serg4life/Qeni_docs/images/prototype.jpg

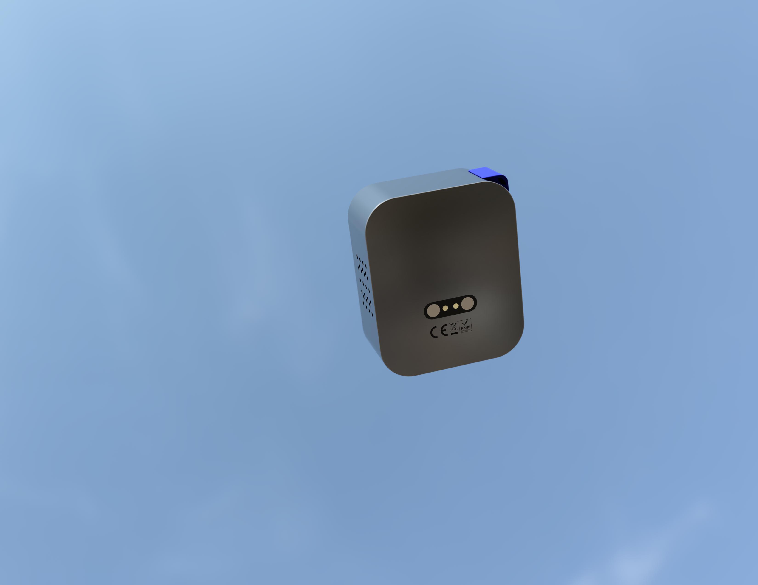
images/prototype.jpg
