serg4life/Qeni_docs/sources/Kicad/Qeniv2.step

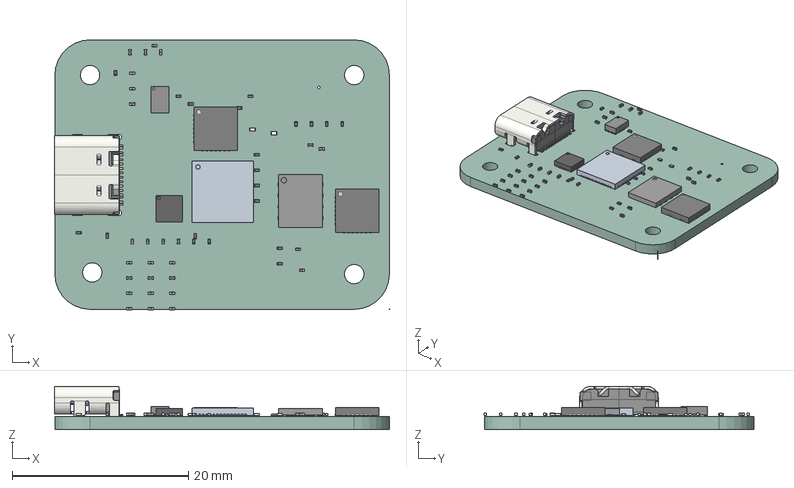
[picture p17: CAD file, 2026-11-05]
sources/Kicad/Qeniv2.step
38.0 x 30.7 x 4.91 mm
R_0201_0603Metric x 19
C_0201_0603Metric x 24
LED_0201_0603Metric x 2
QFN-28-1EP_5x5mm_P0.5mm_EP3.35x3.35mm x 2
L_0201_0603Metric x 4
Espiguchi 1.13.1
TPS62147RGXT
QFN-16 (3x3) Part1
QFN-16 (3x3) Part2 x 16
USB_C_Receptacle_GCT_USB4105-xx-A_16P_TopMnt_Horizontal
ThermalPin
PinsArrayLR
Espiguchi_PCB_1
Espiguchi_PCB_2
