serg4life/Qeni_docs/sources/Kicad/Qeniv2.kicad_pcb

## KiCad design sources/Kicad/Qeniv2.kicad_pcb (2026-11-05)

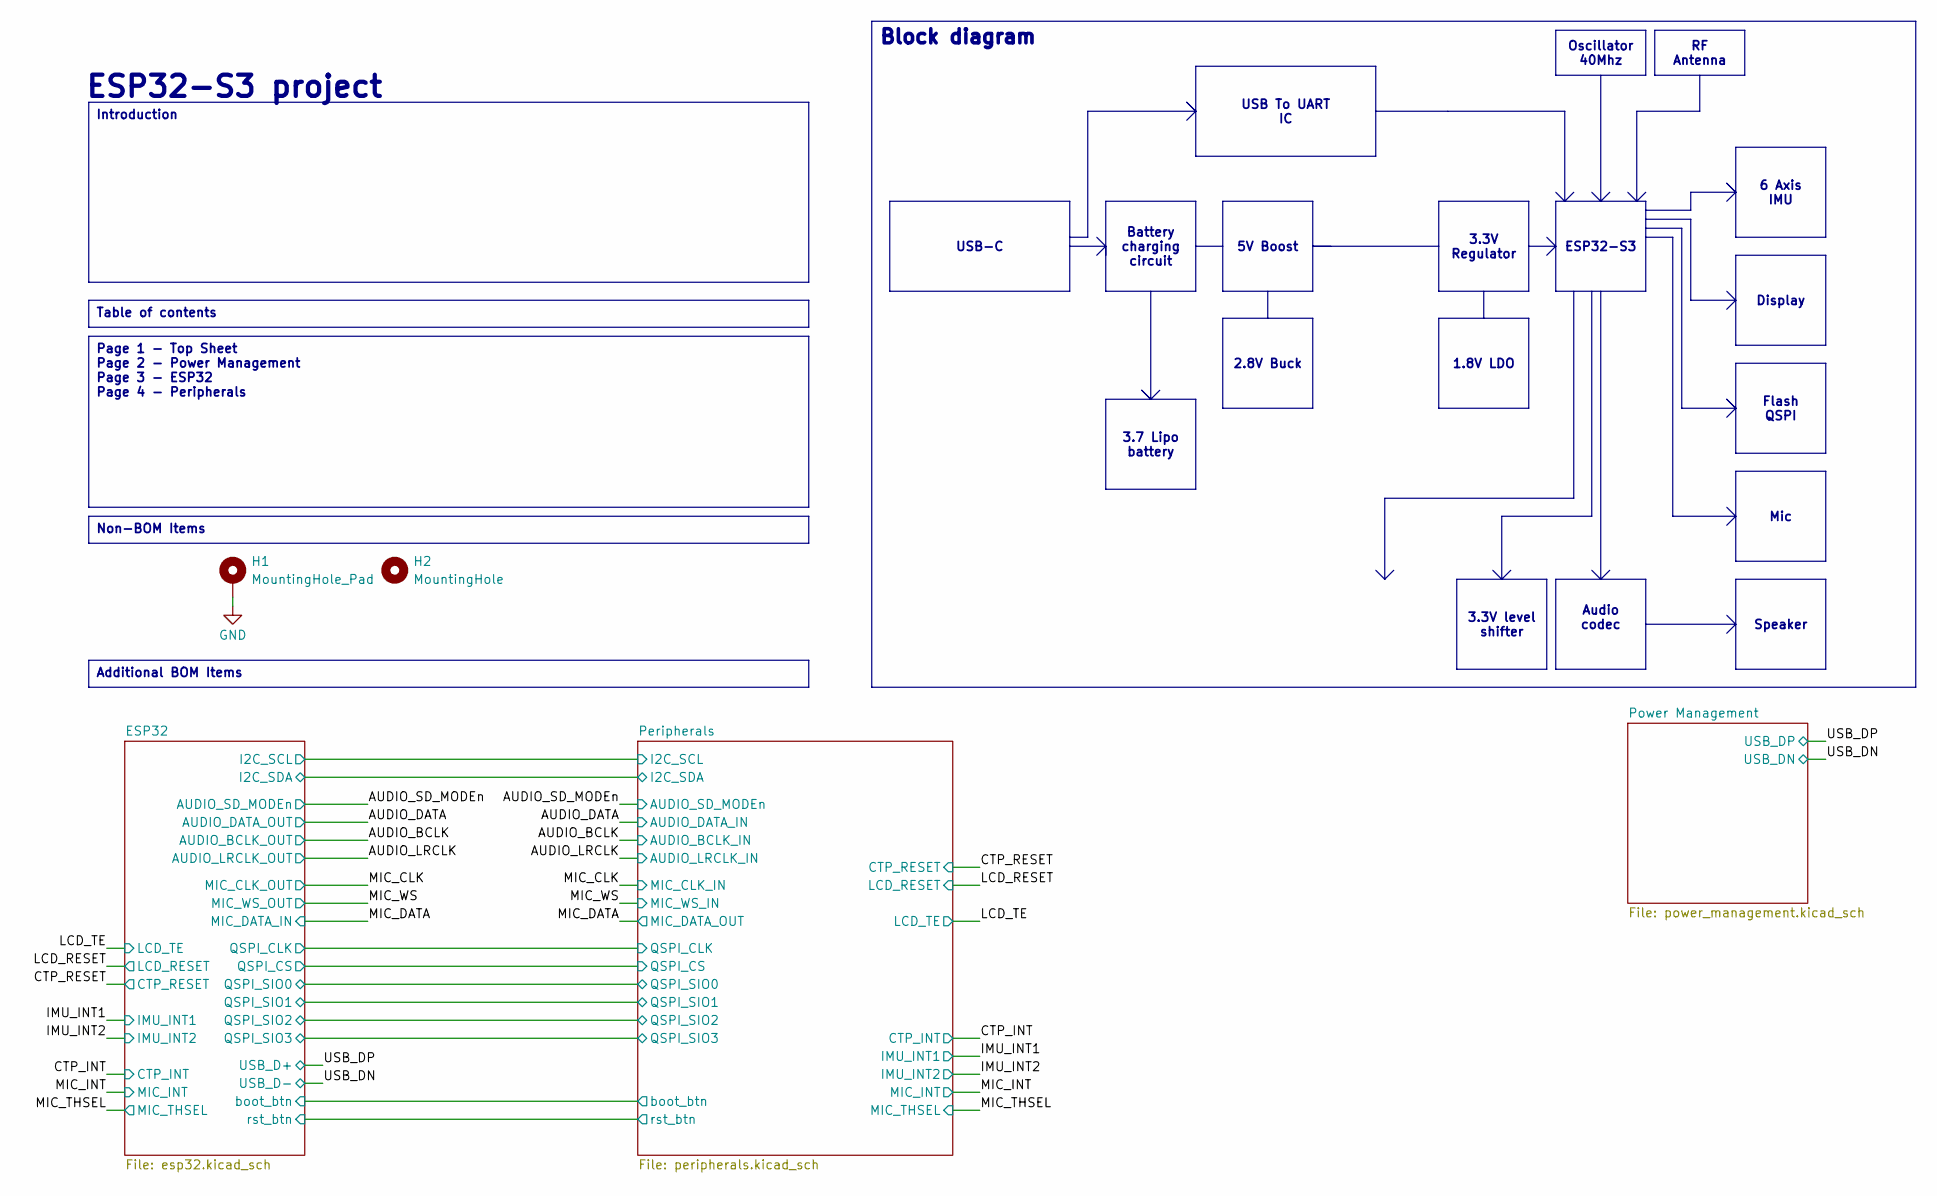
[picture p18: schematic Qeniv2.kicad_sch, Espiguchi-S3]

Parts:
H1: MountingHole_Pad; MountingHole_2.2mm_M2_ISO14580_Pad
H2: MountingHole; MountingHole_2.2mm_M2_ISO7380

Connections:
GND: H1.1; also elsewhere on the board

Notes on the sheet:
ESP32-S3 project
3.3V level shifter
RF Antenna
2.8V Buck
Additional BOM Items
Display
USB-C
6 Axis IMU
Battery charging circuit
Block diagram
Page 1 - Top Sheet Page 2 - Power Management Page 3 - ESP32 Page 4 - Peripherals
Table of contents
Introduction
Mic
1.8V LDO
ESP32-S3
Oscillator 40Mhz
5V Boost
3.3V Regulator
USB To UART IC
Audio codec
3.7 Lipo battery
Non-BOM Items
Flash QSPI
Speaker

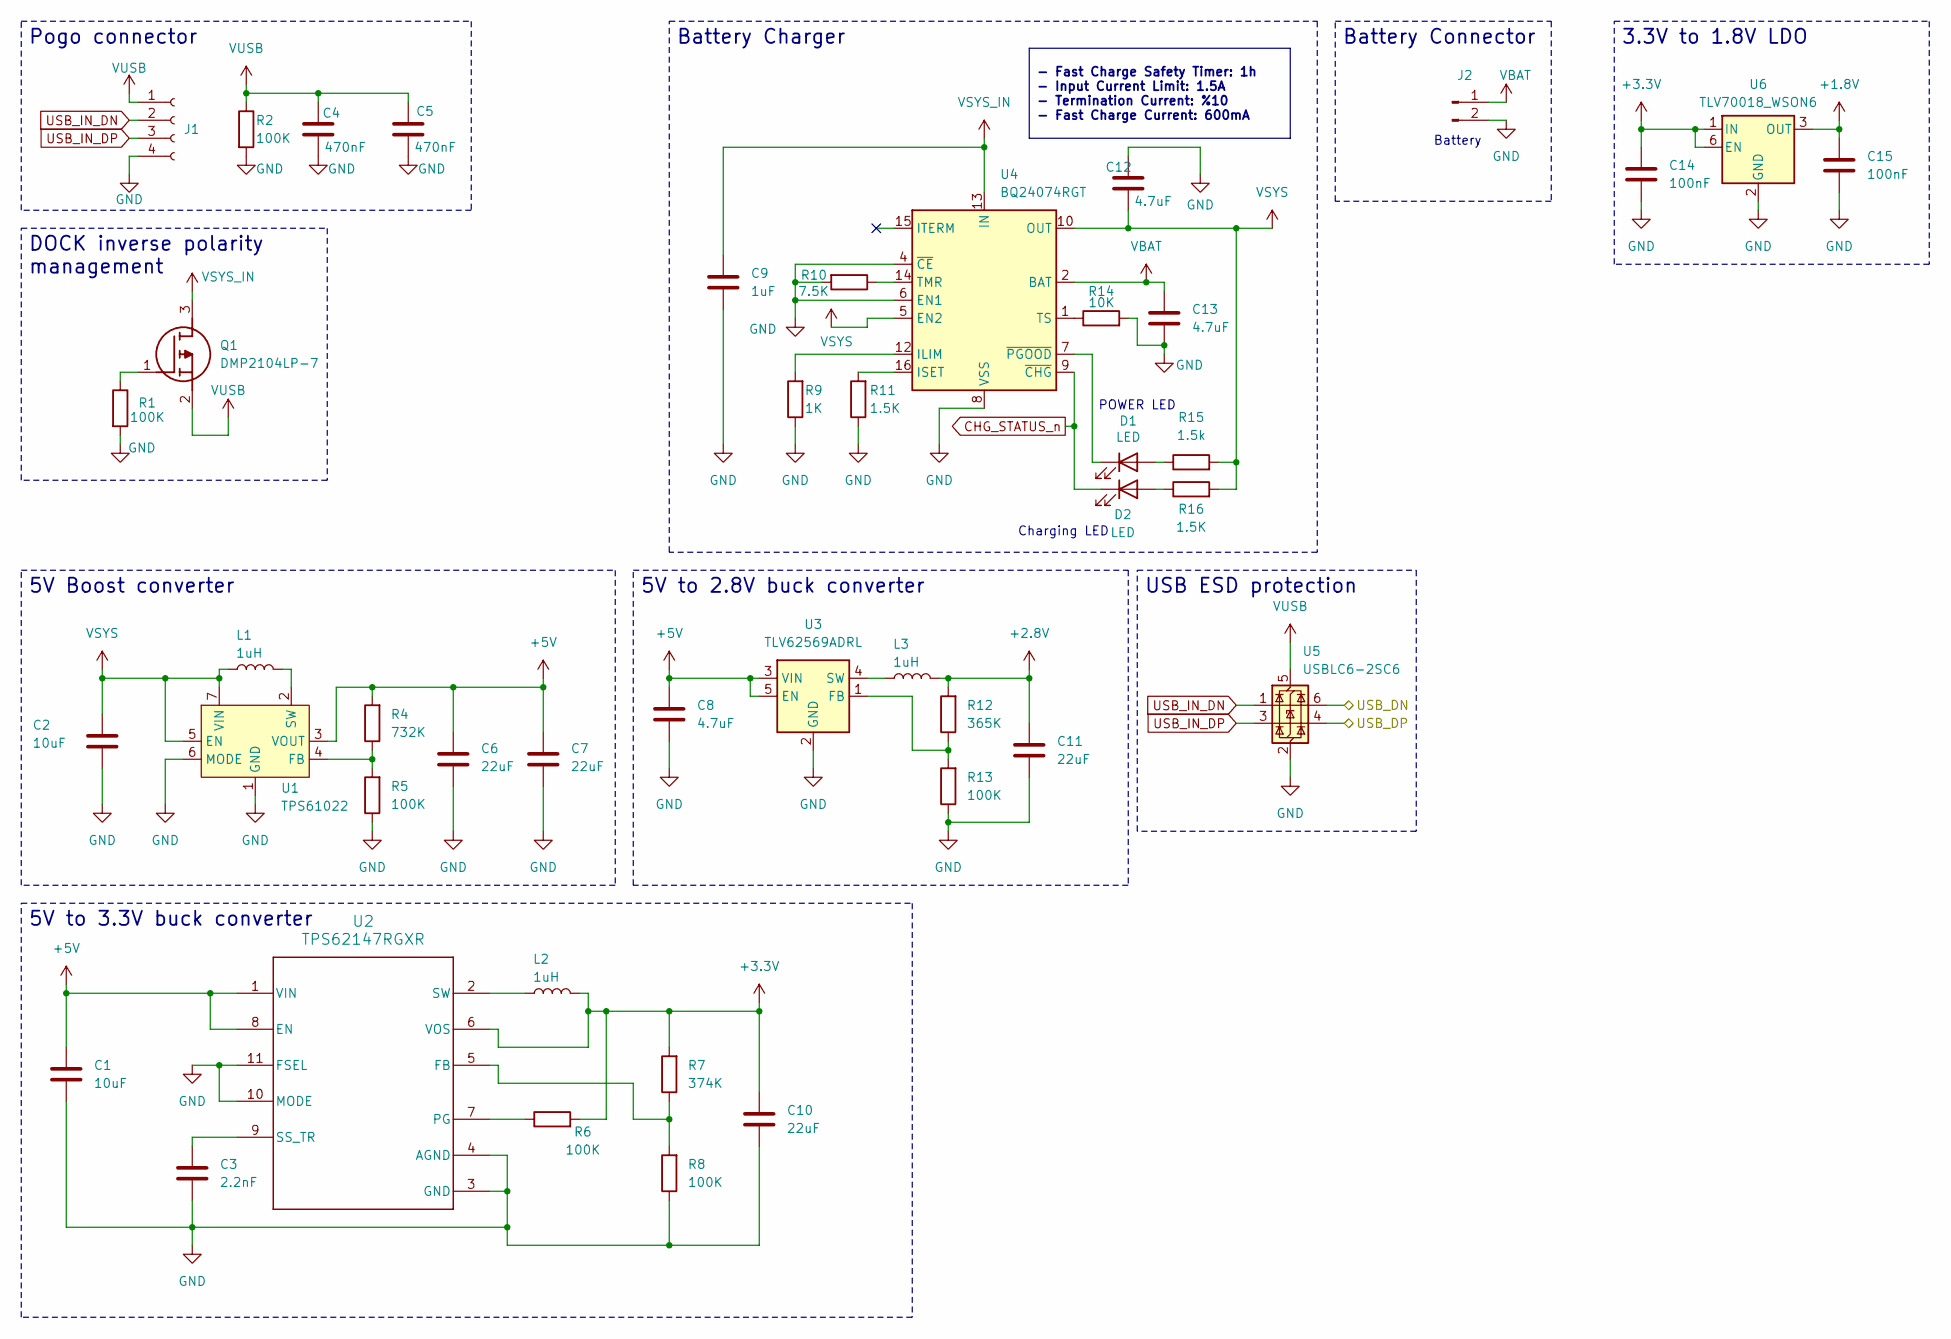
[picture p19: schematic power_management.kicad_sch, Qeni]

Parts:
C1: 10uF; C_0603_1608Metric; Part Number C0603C106M9PACTU
C2: 10uF; C_0805_2012Metric; Part Number C0805C106K8PACTU
C3: 2.2nF; C_0402_1005Metric; Part Number GRM155R71E222KA01D
C4, C5: 470nF; C_0201_0603Metric
C6, C7: 22uF; C_0805_2012Metric_Pad1.18x1.45mm_HandSolder; Part Number MSASL219LB5226MTNA01
C8: 4.7uF; C_0603_1608Metric; Part Number C1608X7S1A475K080AC
C9: 1uF; C_0201_0603Metric
C10, C11: 22uF; C_0603_1608Metric; Part Number GRM188R60J226MEA0D
C12, C13: 4.7uF; C_0201_0603Metric
C14: 100nF; C_0201_0603Metric; Part Number GRM155R71C104KA88D
C15: 100nF; C_0201_0603Metric; Part Number C0603X5R1A104K030BC
D1, D2: LED; LED_0201_0603Metric
J1: Conn_01x02_Socket; pogo_pads_1x4
J2: Conn_01x02_Pin; soldered
L1: 1uH; L_Coilcraft_XxL4020; Part Number XFL4020-102MEB
L2: 1uH; INDC2012X100N; Part Number 74479276210C
L3: 1uH; INDC3030X200N; Part Number 74438336010HT
Q1: DMP2104LP-7; DMP2104LP7; Mouser Part Number 621-DMP2104LP-7
R1, R2: 100K; R_0201_0603Metric
R4: 732K; R_0402_1005Metric_Pad0.72x0.64mm_HandSolder; Part Number CRCW0402732KFKED
R5: 100K; R_0402_1005Metric_Pad0.72x0.64mm_HandSolder; Part Number CRCW0402100KFKED
R6, R8, R13: 100K; R_0402_1005Metric; Part Number CRCW0402100KFKED
R7: 374K; R_0402_1005Metric; Part Number CRCW0402374KFKED
R9: 1K; R_0201_0603Metric
R10: 7.5K; R_0201_0603Metric
R11, R16: 1.5K; R_0201_0603Metric
R12: 365K; R_0402_1005Metric; Part Number CRCW0402365KFKED
R14: 10K; R_0201_0603Metric
R15: 1.5k; R_0201_0603Metric
U1: TPS61022; Texas_RWU0007A_VQFN-7_2x2mm_P0.5mm; Part Number TPS61022RWUR
U2: TPS62147RGXR; RGX0011A
U3: TLV62569ADRL; SOT-563; Part Number TLV62569ADRLR
U4: BQ24074RGT; VQFN-16-1EP_3x3mm_P0.5mm_EP1.6x1.6mm
U5: USBLC6-2SC6; SOT-23-6
U6: TLV70018_WSON6; WSON-6_1.5x1.5mm_P0.5mm; Part Number TLV70018DDCR

Connections:
+1.8V: C15.1, U6.3 (OUT); also elsewhere on the board
+2.8V: C11.1, L3.2, R12.2; also elsewhere on the board
+3.3V: C10.1, C14.1, L2.2, R6.2, R7.2, U2.6 (VOS), U6.1 (IN), U6.6 (EN); also elsewhere on the board
+5V: C1.1, C6.1, C7.1, C8.1, R4.2, U1.3 (VOUT), U2.1 (VIN), U2.8 (EN), U3.3 (VIN), U3.5 (EN); also elsewhere on the board
/USB_DN: U5.6 (I/O1); also elsewhere on the board
/USB_DP: U5.4 (I/O2); also elsewhere on the board
CHG_STATUS_n: D2.1 (K), U4.9 (~CHG); also elsewhere on the board
GND: C1.2, C2.2, C3.2, C4.2, C5.2, C6.2, C7.2, C8.2, C9.2, C10.2, C11.2, C12.1, C13.2, C14.2, C15.2, J1.4, J2.2, R1.2, R2.2, R5.1, R8.1, R9.1, R10.2, R11.1, R13.1, R14.2, U1.1 (GND), U1.6 (MODE), U2.3 (GND), U2.4 (AGND), U2.10 (MODE), U2.11 (FSEL), U3.2 (GND), U4.4 (~CE), U4.6 (EN1), U4.8 (VSS), U4.17 (VSS), U5.2 (GND), U6.2 (GND); also elsewhere on the board
unnamed: D1.2 (A), R15.1
unnamed: D1.1 (K), U4.7 (~PGOOD)
unnamed: D2.2 (A), R16.1
unnamed: Q1.1 (G), R1.1
unnamed: R4.1, R5.2, U1.4 (FB)
unnamed: L1.2, U1.2 (SW)
unnamed: R7.1, R8.2, U2.5 (FB)
unnamed: R6.1, U2.7 (PG)
unnamed: C3.1, U2.9 (SS_TR)
unnamed: L2.1, U2.2 (SW)
unnamed: R12.1, R13.2, U3.1 (FB)
unnamed: L3.1, U3.4 (SW)
unnamed: R9.2, U4.12 (ILIM)
unnamed: R11.2, U4.16 (ISET)
unnamed: R10.1, U4.14 (TMR)
unnamed: R14.1, U4.1 (TS)
USB_IN_DN: J1.2, U5.1 (I/O1)
USB_IN_DP: J1.3, U5.3 (I/O2)
VBAT: C13.1, J2.1, U4.2 (BAT), U4.3 (BAT)
VSYS: C2.1, C12.2, L1.1, R15.2, R16.2, U1.5 (EN), U1.7 (VIN), U4.5 (EN2), U4.10 (OUT), U4.11 (OUT)
VSYS_IN: C9.1, Q1.3 (D), U4.13 (IN)
VUSB: C4.1, C5.1, J1.1, Q1.2 (S), R2.1, U5.5 (VBUS)

Notes on the sheet:
POWER LED
Charging LED
Battery
USB ESD protection
Pogo connector
5V Boost converter
3.3V to 1.8V LDO
5V to 3.3V buck converter
Battery Charger
- Fast Charge Safety Timer: 1h - Input Current Limit: 1.5A - Termination Current: %10 - Fast Charge Current: 600mA
DOCK inverse polarity management
Battery Connector
5V to 2.8V buck converter

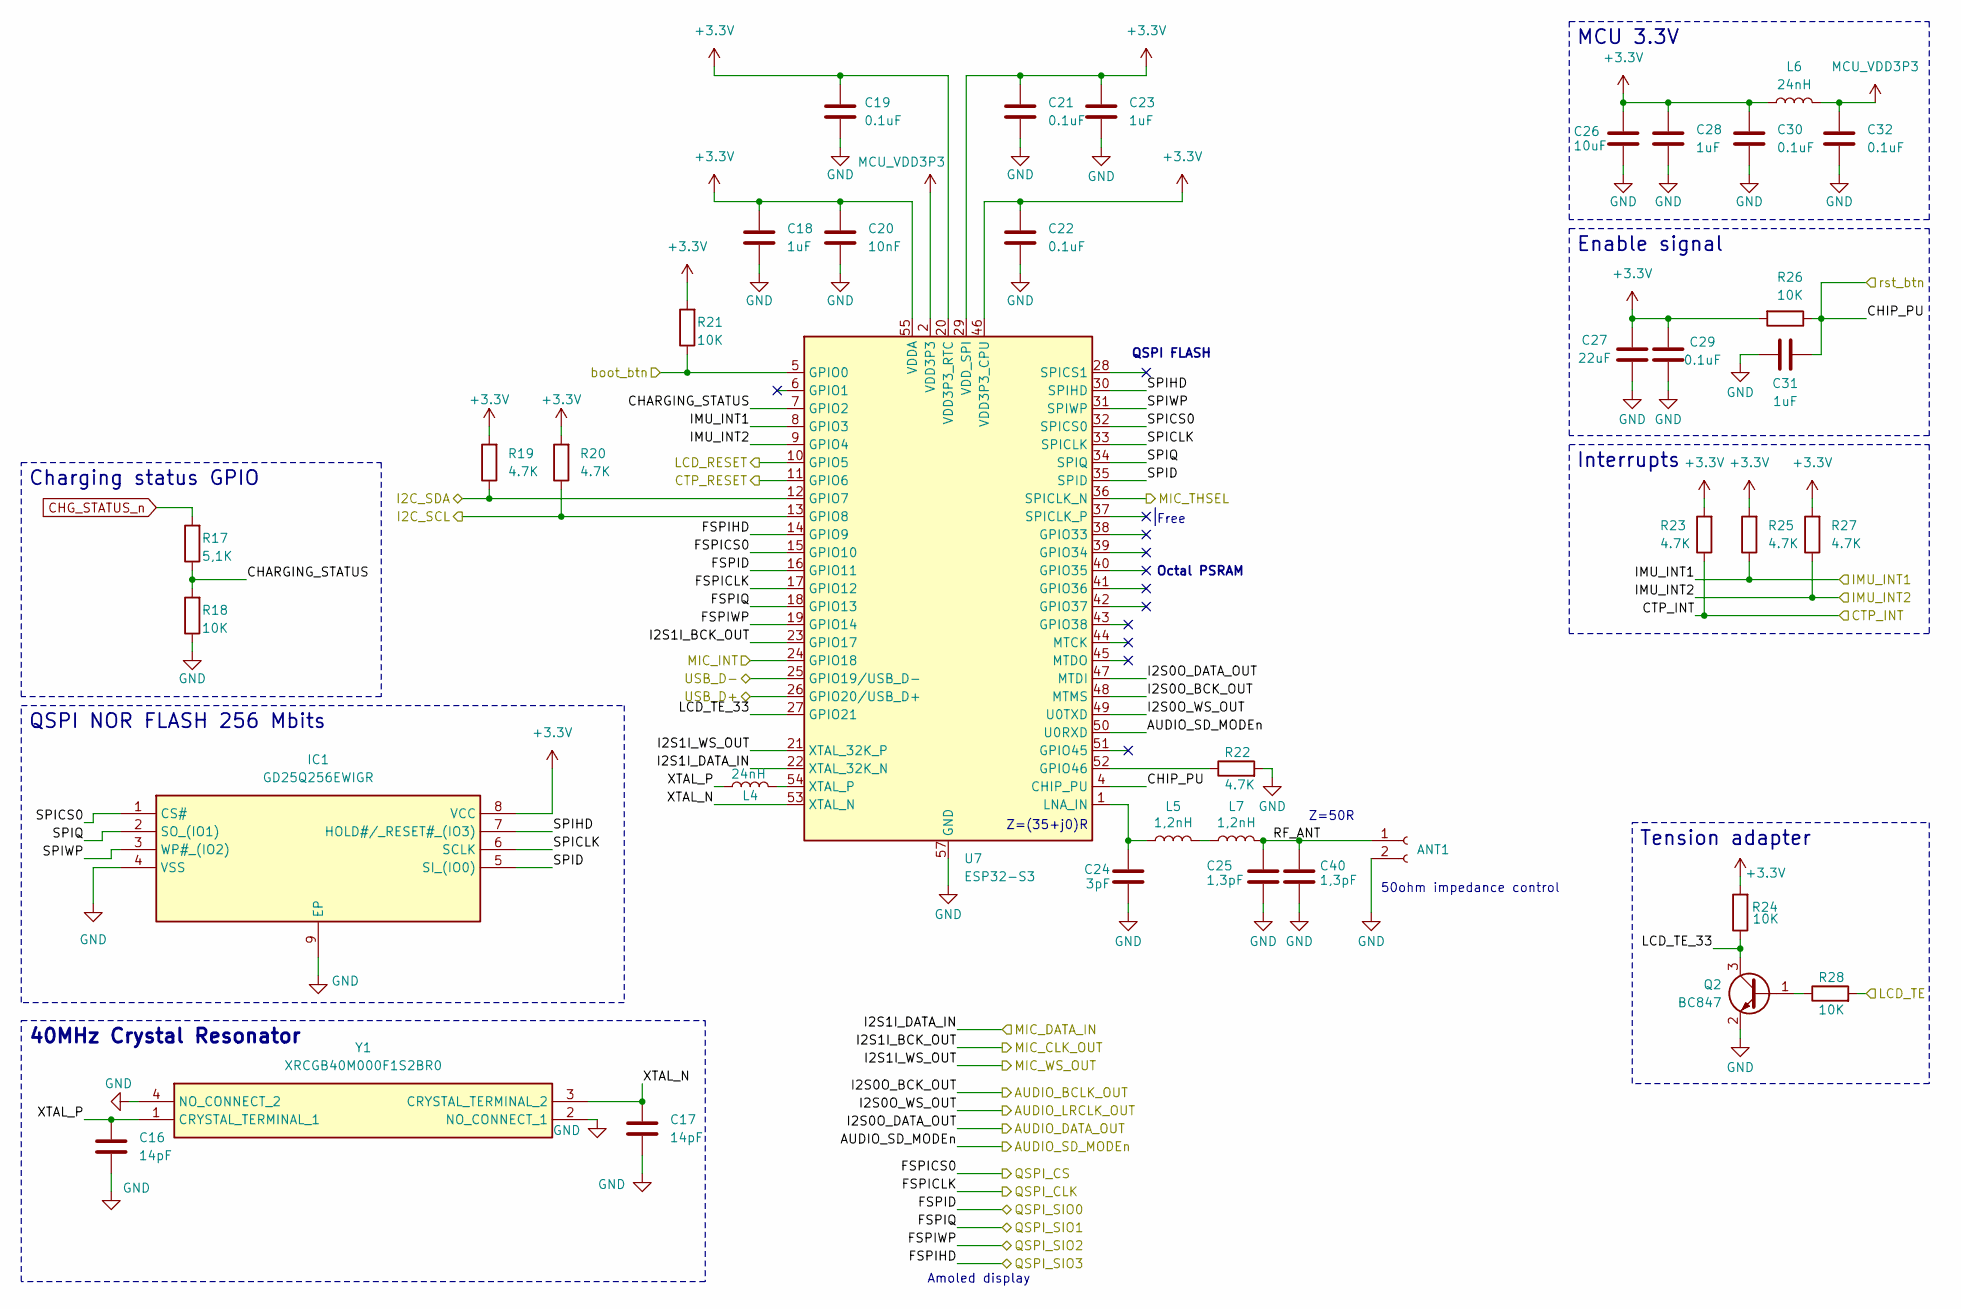
[picture p20: schematic esp32.kicad_sch, Qeni]

Parts:
ANT1: Conn_01x02_Socket; Texas_SWRA117D_2.4GHz_Left
C16, C17: 14pF; C_0201_0603Metric
C18, C23, C28, C31: 1uF; C_0201_0603Metric
C19, C21, C22, C29, C30, C32: 0.1uF; C_0201_0603Metric
C20: 10nF; C_0201_0603Metric
C24: 3pF; C_0201_0603Metric
C25, C40: 1,3pF; C_0201_0603Metric
C26: 10uF; C_0603_1608Metric
C27: 22uF; C_0805_2012Metric
IC1: GD25Q256EWIGR; SON127P500X600X80-9N-D; Manufacturer_Part_Number GD25Q256EWIGR
L4, L6: 24nH; L_0201_0603Metric
L5, L7: 1,2nH; L_0201_0603Metric
Q2: BC847; SOT-23
R17: 5,1K; R_0201_0603Metric
R18, R21, R24, R26, R28: 10K; R_0201_0603Metric
R19, R20, R22, R23, R25, R27: 4.7K; R_0201_0603Metric
U7: ESP32-S3; QFN-56-1EP_7x7mm_P0.4mm_EP4x4mm
Y1: XRCGB40M000F1S2BR0; Manufacturer_Part_Number XRCGB40M000F1S2BR0

Connections:
+3.3V: C18.1, C19.2, C20.1, C21.2, C22.2, C23.1, C26.2, C27.2, C28.2, C29.1, C30.2, IC1.8 (VCC), L6.1, R19.2, R20.2, R21.2, R23.2, R24.2, R25.2, R26.2, R27.2, U7.20 (VDD3P3_RTC), U7.29 (VDD_SPI), U7.46 (VDD3P3_CPU), U7.55 (VDDA), U7.56 (VDDA); also elsewhere on the board
/AUDIO_BCLK: U7.48 (MTMS); also elsewhere on the board
/AUDIO_DATA: U7.47 (MTDI); also elsewhere on the board
/AUDIO_LRCLK: U7.49 (U0TXD); also elsewhere on the board
/AUDIO_SD_MODEn: U7.50 (U0RXD); also elsewhere on the board
/CTP_INT: R23.1; also elsewhere on the board
/CTP_RESET: U7.11 (GPIO6); also elsewhere on the board
/ESP32/CHARGING_STATUS: R17.1, R18.2, U7.7 (GPIO2)
/ESP32/CHIP_PU: C31.2, R26.1, U7.4 (CHIP_PU); also elsewhere on the board
/ESP32/FSPICLK: U7.17 (GPIO12); also elsewhere on the board
/ESP32/FSPICS0: U7.15 (GPIO10); also elsewhere on the board
/ESP32/FSPID: U7.16 (GPIO11); also elsewhere on the board
/ESP32/FSPIHD: U7.14 (GPIO9); also elsewhere on the board
/ESP32/FSPIQ: U7.18 (GPIO13); also elsewhere on the board
/ESP32/FSPIWP: U7.19 (GPIO14); also elsewhere on the board
/ESP32/LCD_TE_33: Q2.3 (C), R24.1, U7.27 (GPIO21)
/ESP32/RF_ANT: ANT1.1, C25.1, C40.1, L7.2
/ESP32/SPICLK: IC1.6 (SCLK), U7.33 (SPICLK)
/ESP32/SPICS0: IC1.1 (CS#), U7.32 (SPICS0)
/ESP32/SPID: IC1.5 (SI_(IO0)), U7.35 (SPID)
/ESP32/SPIHD: IC1.7 (HOLD#/_RESET#_(IO3)), U7.30 (SPIHD)
/ESP32/SPIQ: IC1.2 (SO_(IO1)), U7.34 (SPIQ)
/ESP32/SPIWP: IC1.3 (WP#_(IO2)), U7.31 (SPIWP)
/ESP32/XTAL_N: C17.1, U7.53 (XTAL_N), Y1.3 (CRYSTAL_TERMINAL_2)
/ESP32/XTAL_P: C16.1, L4.1, Y1.1 (CRYSTAL_TERMINAL_1)
/ESP32/boot_btn: R21.1, U7.5 (GPIO0); also elsewhere on the board
/IMU_INT1: R25.1, U7.8 (GPIO3); also elsewhere on the board
/IMU_INT2: R27.1, U7.9 (GPIO4); also elsewhere on the board
/LCD_RESET: U7.10 (GPIO5); also elsewhere on the board
/LCD_TE: R28.2; also elsewhere on the board
/MIC_CLK: U7.23 (GPIO17); also elsewhere on the board
/MIC_DATA: U7.22 (XTAL_32K_N); also elsewhere on the board
/MIC_INT: U7.24 (GPIO18); also elsewhere on the board
/MIC_THSEL: U7.36 (SPICLK_N); also elsewhere on the board
/MIC_WS: U7.21 (XTAL_32K_P); also elsewhere on the board
/Peripherals/CTP_SCL: R20.1, U7.13 (GPIO8); also elsewhere on the board
/Peripherals/CTP_SDA: R19.1, U7.12 (GPIO7); also elsewhere on the board
/USB_DN: U7.25 (GPIO19/USB_D-); also elsewhere on the board
/USB_DP: U7.26 (GPIO20/USB_D+); also elsewhere on the board
CHG_STATUS_n: R17.2; also elsewhere on the board
GND: ANT1.2, C16.2, C17.2, C18.2, C19.1, C20.2, C21.1, C22.1, C23.2, C24.2, C25.2, C26.1, C27.1, C28.1, C29.2, C30.1, C31.1, C32.1, C40.2, IC1.4 (VSS), IC1.9 (EP), Q2.2 (E), R18.1, R22.2, U7.57 (GND), Y1.2 (NO_CONNECT_1), Y1.4 (NO_CONNECT_2); also elsewhere on the board
MCU_VDD3P3: C32.2, L6.2, U7.2 (VDD3P3), U7.3 (VDD3P3)
unnamed: L5.2, L7.1
unnamed: Q2.1 (B), R28.1
unnamed: R22.1, U7.52 (GPIO46)
unnamed: C24.1, L5.1, U7.1 (LNA_IN)
unnamed: L4.2, U7.54 (XTAL_P)

Notes on the sheet:
Amoled display
Octal PSRAM
50ohm impedance control
Free
Z=50R
Z=(35+j0)R
QSPI FLASH
40MHz Crystal Resonator
Tension adapter
Enable signal
Interrupts
QSPI NOR FLASH 256 Mbits
Charging status GPIO
MCU 3.3V

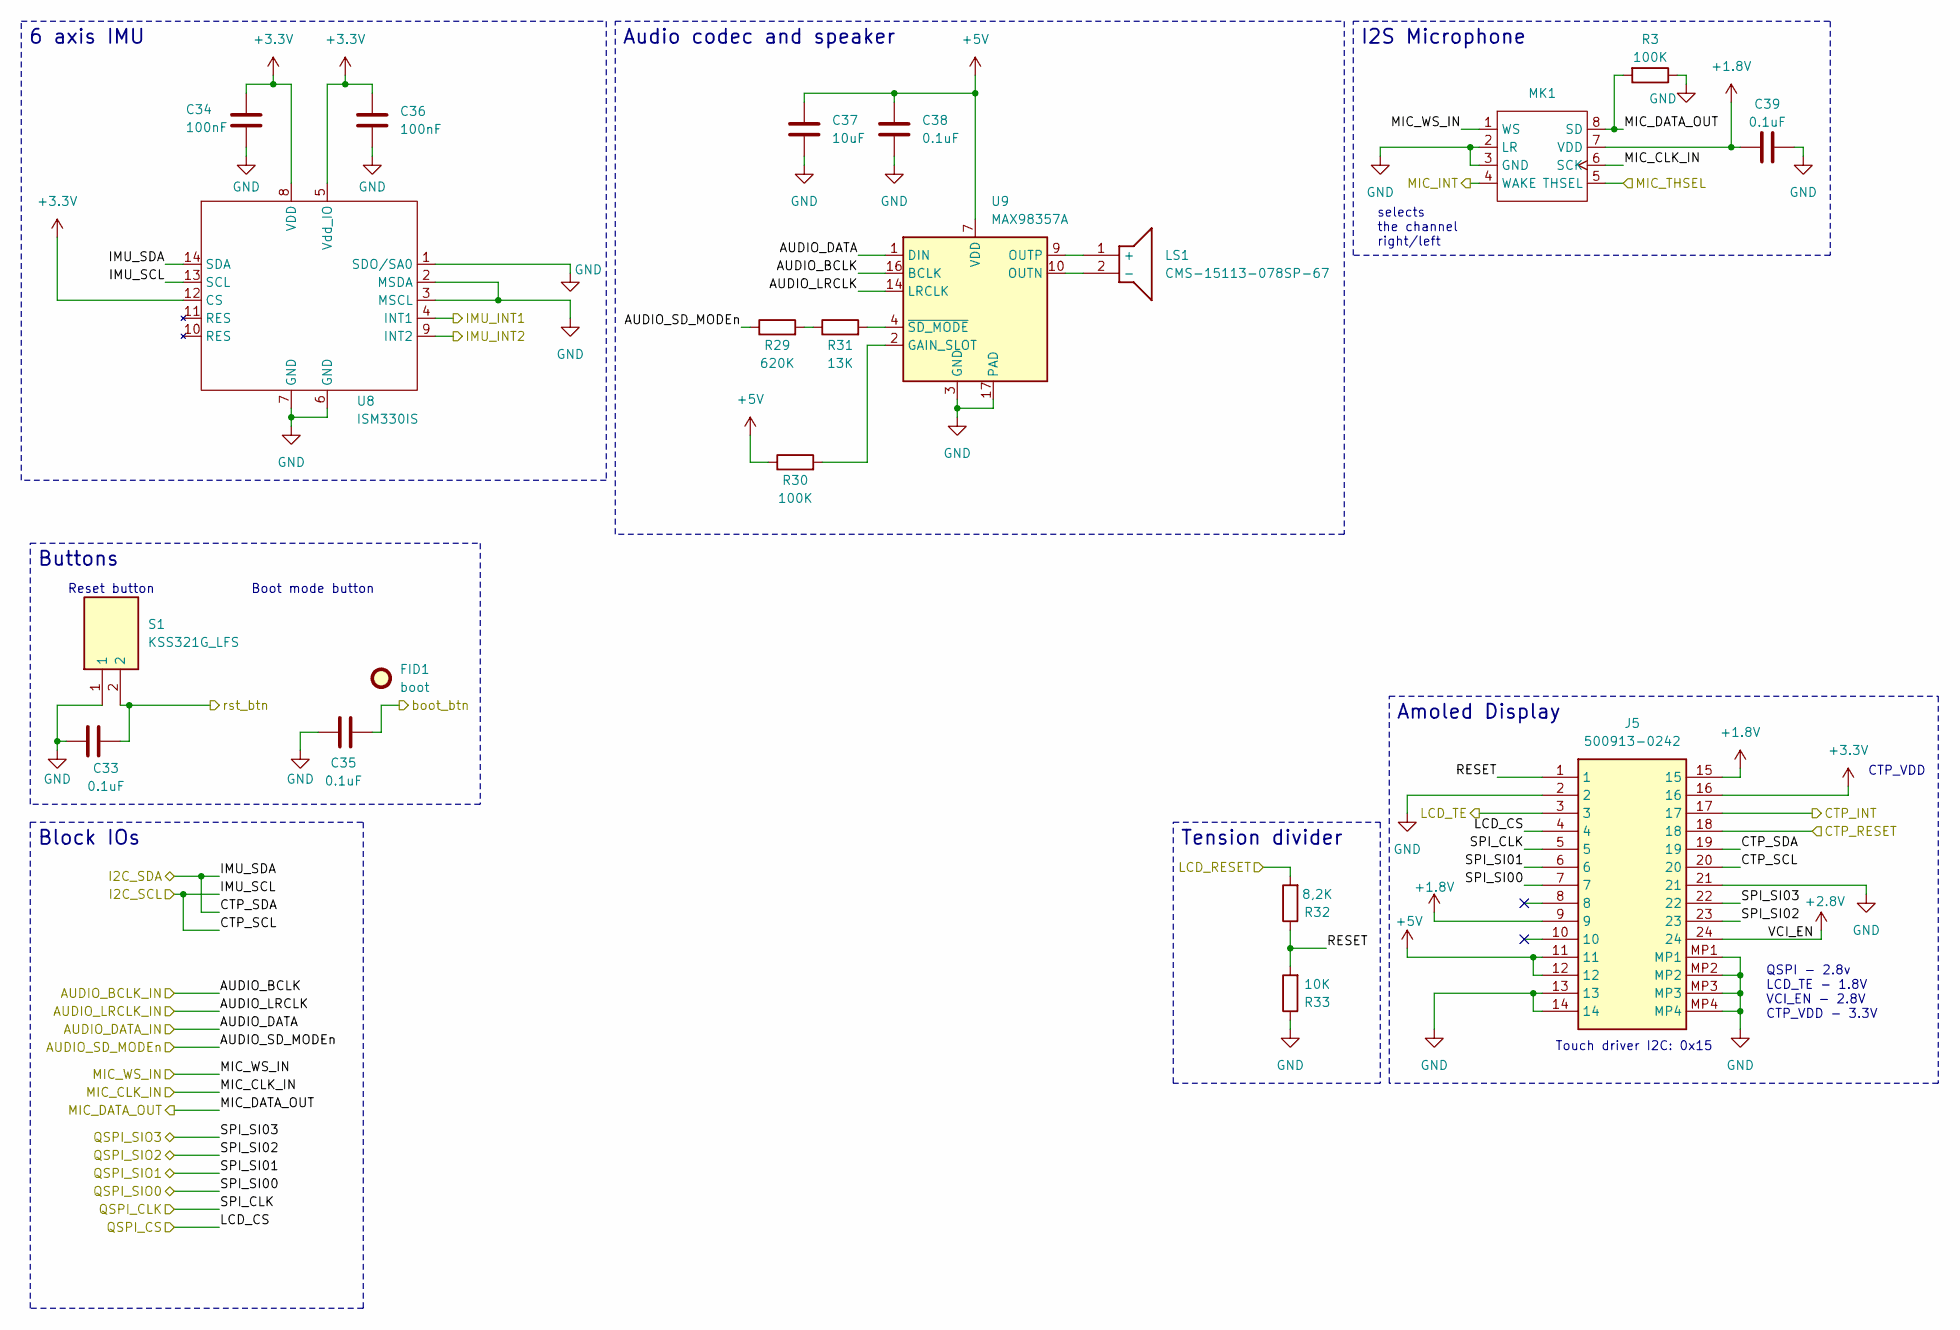
[picture p21: schematic peripherals.kicad_sch, Qeni]

Parts:
C33, C35, C38, C39: 0.1uF; C_0201_0603Metric
C34, C36: 100nF; C_0201_0603Metric
C37: 10uF; C_0603_1608Metric
FID1: boot; Fiducial_0.5mm_Mask1mm
J5: 500913-0242; OK-23GF024-04; Mouser Part Number 538-500913-0242
LS1: CMS-15113-078SP-67; Audio pad; Mouser Part Number 490-CMS-15113078SP67
MK1: MMICT5848
R3, R30: 100K; R_0201_0603Metric
R29: 620K; R_0201_0603Metric
R31: 13K; R_0201_0603Metric
R32: 8,2K; R_0201_0603Metric
R33: 10K; R_0201_0603Metric
S1: KSS321G_LFS; KSS321GLFS; Manufacturer_Part_Number KSS321G LFS
U8: ISM330IS
U9: MAX98357A; TQFN-16-1EP_3x3mm_P0.5mm_EP1.23x1.23mm

Connections:
+1.8V: C39.1, J5.9, J5.15, MK1.7 (VDD); also elsewhere on the board
+2.8V: J5.24; also elsewhere on the board
+3.3V: C34.1, C36.1, J5.16, U8.5 (Vdd_IO), U8.8 (VDD), U8.12 (CS); also elsewhere on the board
+5V: C37.1, C38.1, J5.11, J5.12, R30.1, U9.7 (VDD), U9.8 (VDD); also elsewhere on the board
/AUDIO_BCLK: U9.16 (BCLK); also elsewhere on the board
/AUDIO_DATA: U9.1 (DIN); also elsewhere on the board
/AUDIO_LRCLK: U9.14 (LRCLK); also elsewhere on the board
/AUDIO_SD_MODEn: R29.1; also elsewhere on the board
/CTP_INT: J5.17; also elsewhere on the board
/CTP_RESET: J5.18; also elsewhere on the board
/ESP32/CHIP_PU: C33.2, S1.2; also elsewhere on the board
/ESP32/FSPICLK: J5.5; also elsewhere on the board
/ESP32/FSPICS0: J5.4; also elsewhere on the board
/ESP32/FSPID: J5.7; also elsewhere on the board
/ESP32/FSPIHD: J5.22; also elsewhere on the board
/ESP32/FSPIQ: J5.6; also elsewhere on the board
/ESP32/FSPIWP: J5.23; also elsewhere on the board
/ESP32/boot_btn: C35.2; also elsewhere on the board
/IMU_INT1: U8.4 (INT1); also elsewhere on the board
/IMU_INT2: U8.9 (INT2); also elsewhere on the board
/LCD_RESET: R32.2; also elsewhere on the board
/LCD_TE: J5.3; also elsewhere on the board
/MIC_CLK: MK1.6 (SCK); also elsewhere on the board
/MIC_DATA: MK1.8 (SD), R3.2; also elsewhere on the board
/MIC_INT: MK1.4 (WAKE); also elsewhere on the board
/MIC_THSEL: MK1.5 (THSEL); also elsewhere on the board
/MIC_WS: MK1.1 (WS); also elsewhere on the board
/Peripherals/CTP_SCL: J5.20, U8.13 (SCL); also elsewhere on the board
/Peripherals/CTP_SDA: J5.19, U8.14 (SDA); also elsewhere on the board
/Peripherals/RESET: J5.1, R32.1, R33.2
GND: C33.1, C34.2, C35.1, C36.2, C37.2, C38.2, C39.2, J5.2, J5.13, J5.14, J5.21, J5.MP1, J5.MP2, J5.MP3, J5.MP4, MK1.2 (LR), MK1.3 (GND), R3.1, R33.1, S1.1, U8.1 (SDO/SA0), U8.2 (MSDA), U8.3 (MSCL), U8.6 (GND), U8.7 (GND), U9.3 (GND), U9.11 (GND), U9.15 (GND), U9.17 (PAD); also elsewhere on the board
unnamed: LS1.1 (+), U9.9 (OUTP)
unnamed: LS1.2 (-), U9.10 (OUTN)
unnamed: R29.2, R31.1
unnamed: R30.2, U9.2 (GAIN_SLOT)
unnamed: R31.2, U9.4 (~SD_MODE)

Notes on the sheet:
selects the channel right/left
Touch driver I2C: 0x15
CTP_VDD
Boot mode button
Reset button
QSPI - 2.8v LCD_TE - 1.8V VCI_EN - 2.8V CTP_VDD - 3.3V
Buttons
Amoled Display
6 axis IMU
Tension divider
Block IOs
I2S Microphone
Audio codec and speaker

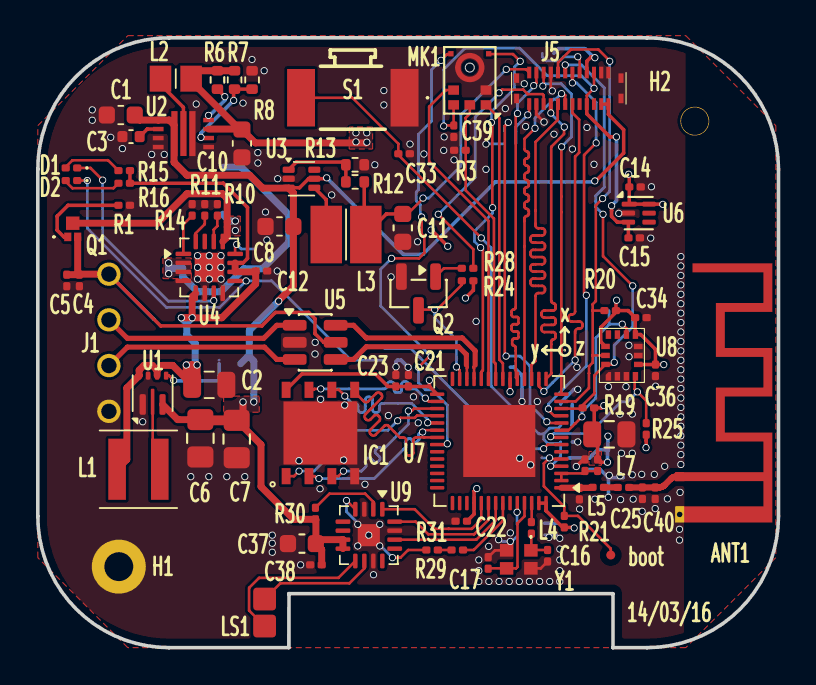
[picture p22: board Qeniv2.kicad_pcb from above]

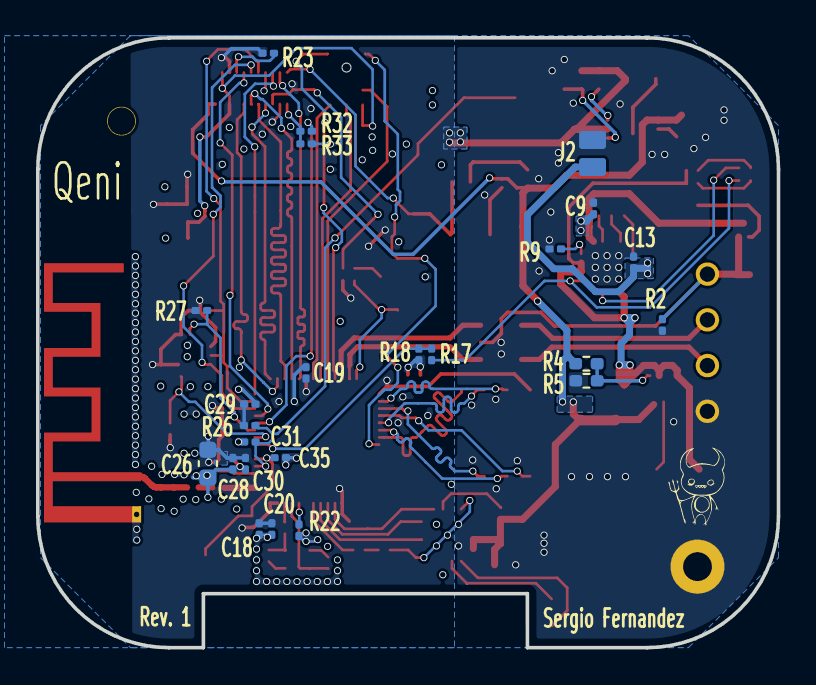
[picture p23: board Qeniv2.kicad_pcb from below]

Board: 4 copper layers, 41.1 x 33.9 mm, 105 parts (24 on the bottom side), 78 nets.
